OatApiwat/ROS_agv/README.md

# ROS_agv

## OverAll Project
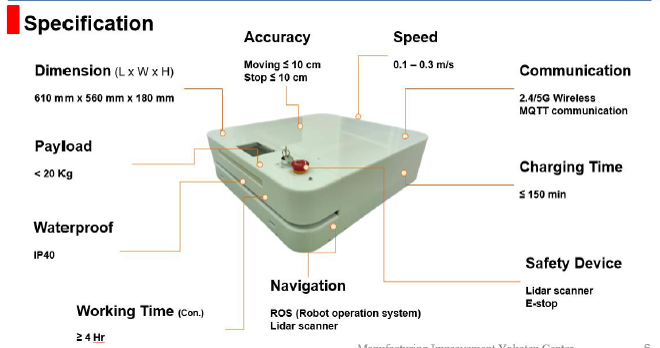
[picture p1: OverAll_AGV.png]
Specification AGV

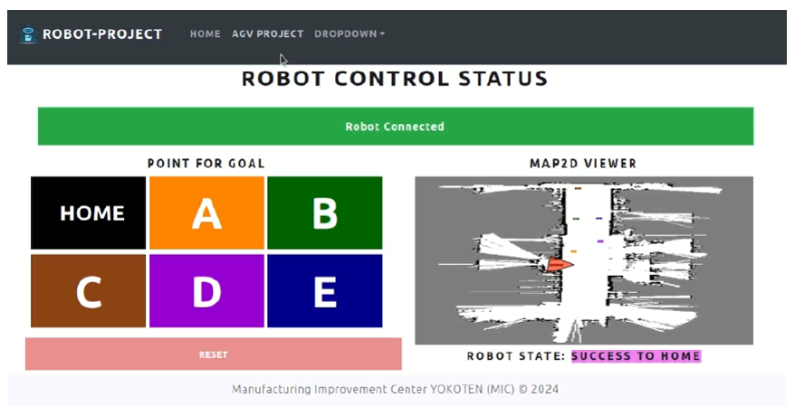
[picture p2: OverAll_web.png]
Web for control_AGV


## Link Working system
[AGV_working](https://youtu.be/HmGA6tf8itk )
[Point_to_Point](https://youtu.be/yPlYCydJhrE)
