OatApiwat/ROS_agv/dwg/Assy_encoder.FCStd

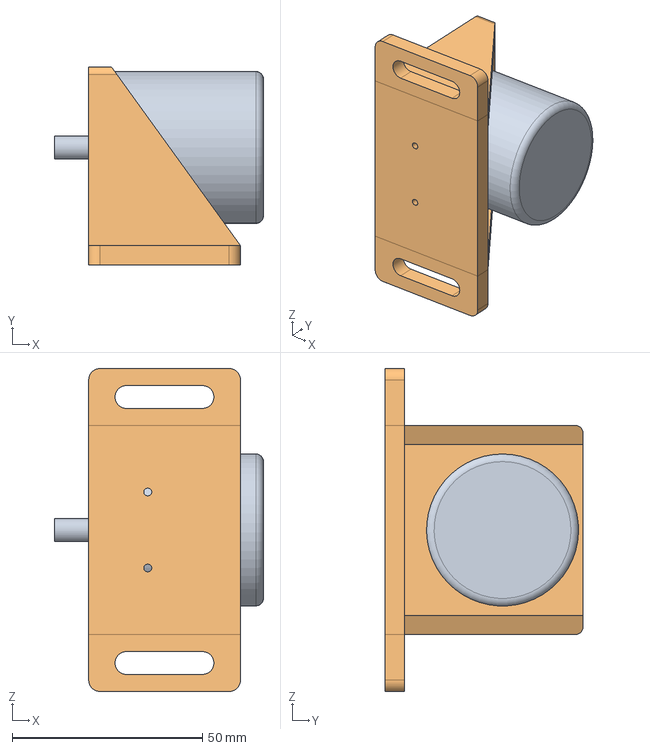
[picture p3: CAD file, 2025-02-19]
dwg/Assy_encoder.FCStd
55.0 x 52.1 x 85.0 mm
encoder_001
encoder_holder3_001
