OatApiwat/ROS_agv/dwg/assy.step

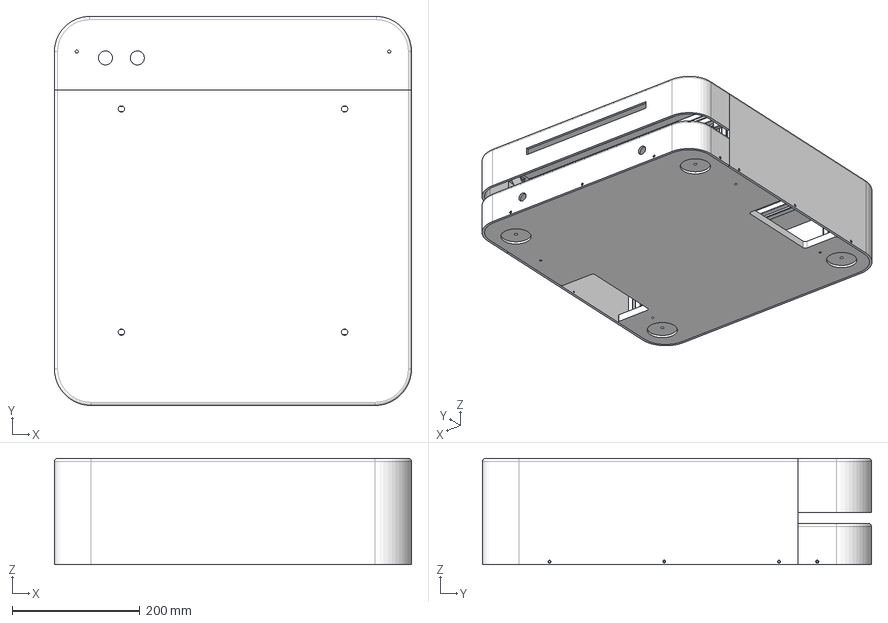
[picture p4: CAD file, 2025-02-19]
dwg/assy.step
560.0 x 610.0 x 167.0 mm
base_001
AGV02-102A_Front cover 1_001
AGV02-103A_Front cover 2_001
frame_set2_001
AGV02-104A_Top cover_001
