OatApiwat/ROS_agv/dwg/cover_wheel_12-6.FCStd

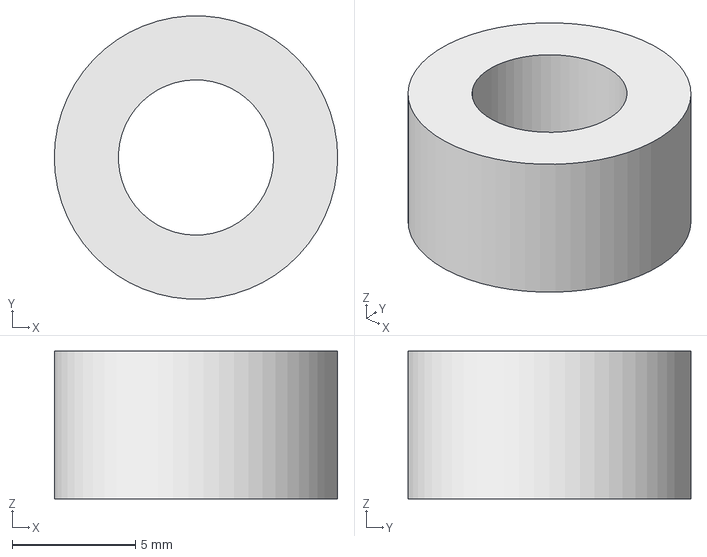
[picture p5: CAD file, 2025-02-19]
dwg/cover_wheel_12-6.FCStd
11.5 x 11.5 x 6.00 mm
