OatApiwat/ROS_agv/dwg/cover_wheel_12-8v2.FCStd

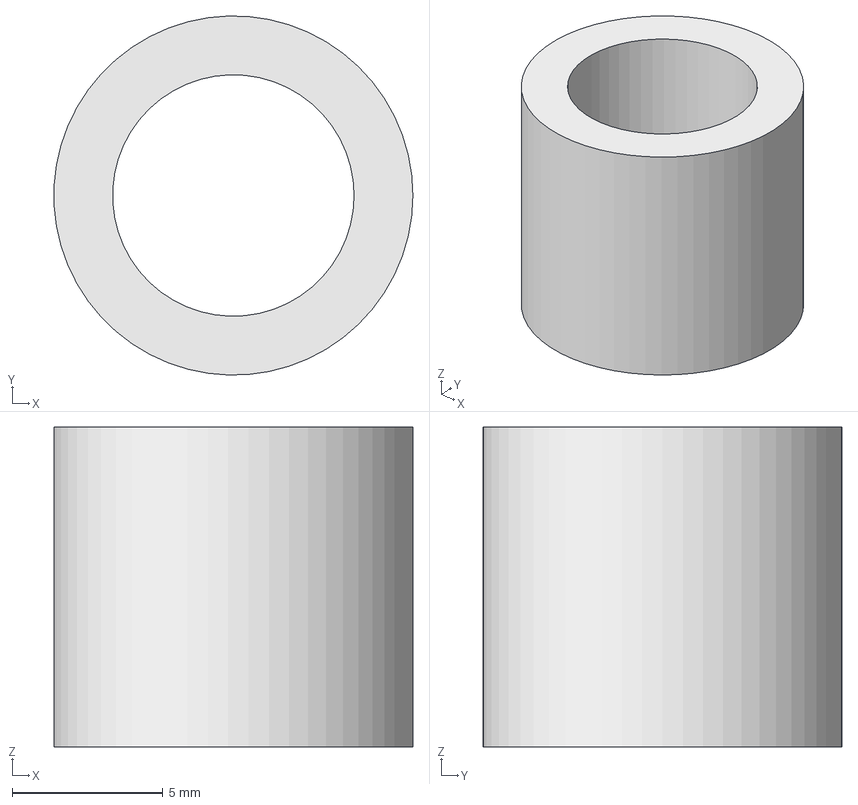
[picture p6: CAD file, 2025-02-19]
dwg/cover_wheel_12-8v2.FCStd
11.9 x 11.9 x 10.6 mm
