OatApiwat/ROS_agv/dwg/cover_wheel_8-6.FCStd

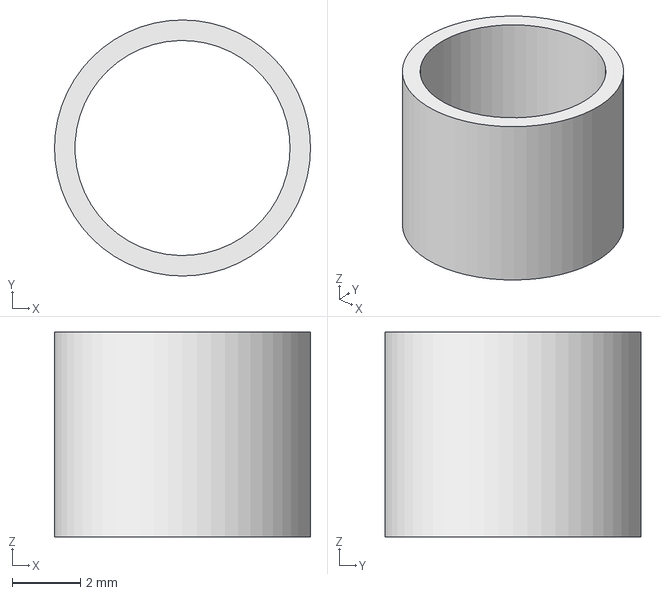
[picture p7: CAD file, 2025-02-19]
dwg/cover_wheel_8-6.FCStd
7.50 x 7.50 x 6.00 mm
