OatApiwat/ROS_agv/dwg/encoder_holder3-Body.stl

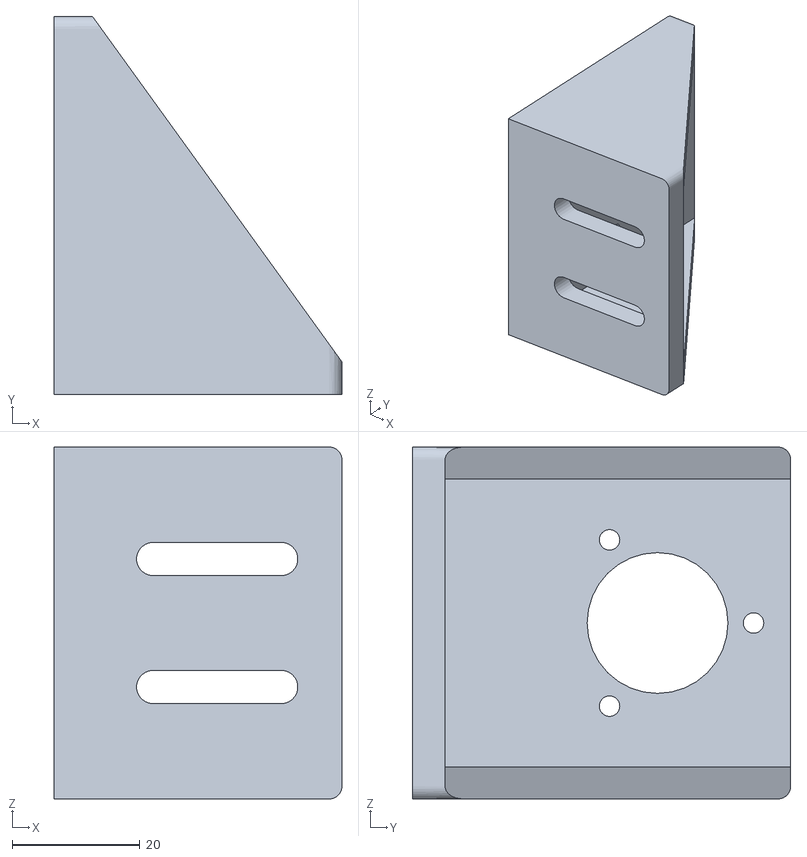
[picture p9: CAD file, 2025-02-19]
dwg/encoder_holder3-Body.stl
45.0 x 59.1 x 55.0
