OatApiwat/ROS_agv/dwg/Base_Lidar_Top-Body.stl

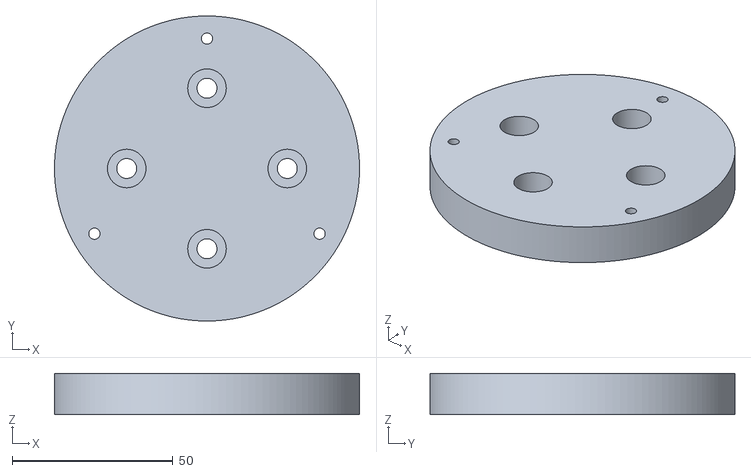
[picture p10: CAD file, 2025-02-19]
dwg/Base_Lidar_Top-Body.stl
95.0 x 95.0 x 12.8
