OatApiwat/ROS_agv/dwg/Base_Lidar.FCStd

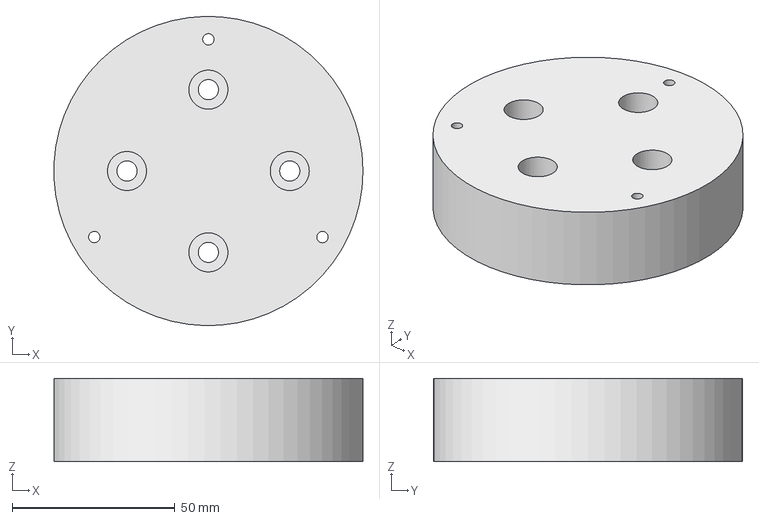
[picture p11: CAD file, 2025-02-19]
dwg/Base_Lidar.FCStd
94.9 x 95.0 x 25.6 mm
