OatApiwat/ROS_agv/dwg/AGV02-103A_Front cover 2.step

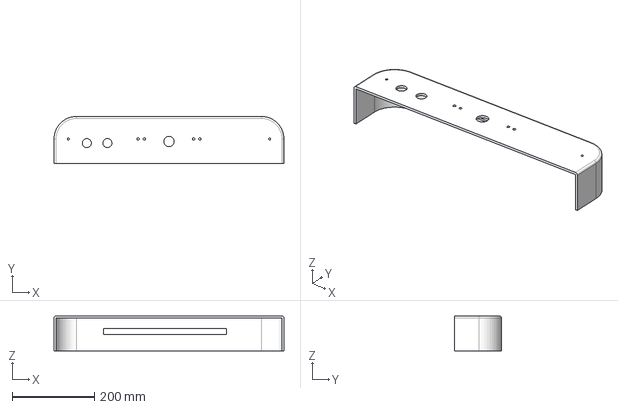
[picture p12: CAD file, 2025-02-19]
dwg/AGV02-103A_Front cover 2.step
560.0 x 115.0 x 85.0 mm
