OatApiwat/ROS_agv/dwg/AGV02-101A_Base chassis.step

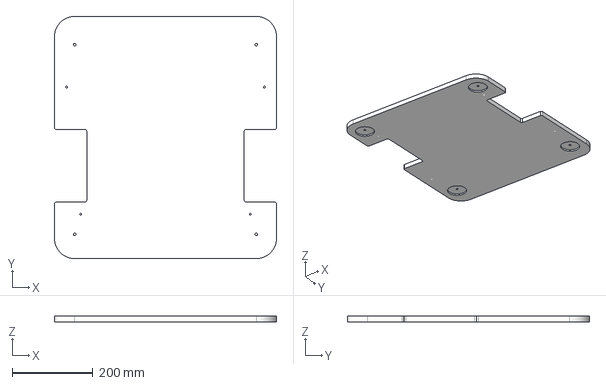
[picture p13: CAD file, 2025-02-19]
dwg/AGV02-101A_Base chassis.step
550.0 x 600.0 x 15.0 mm
