OatApiwat/ROS_agv/dwg/AGV02-104A_Top cover.step

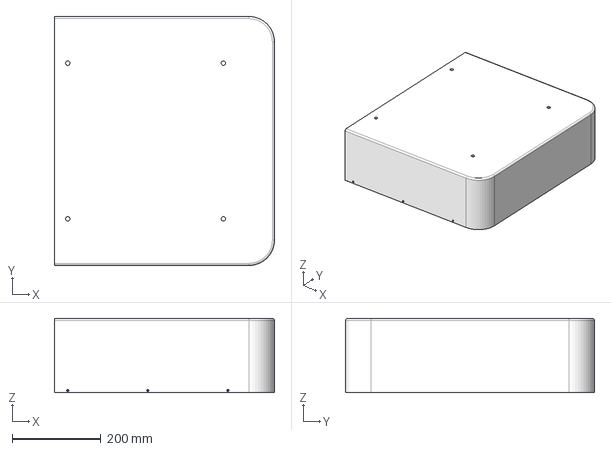
[picture p14: CAD file, 2025-02-19]
dwg/AGV02-104A_Top cover.step
495.0 x 560.0 x 167.0 mm
