OatApiwat/ROS_agv/dwg/motor24v.FCStd

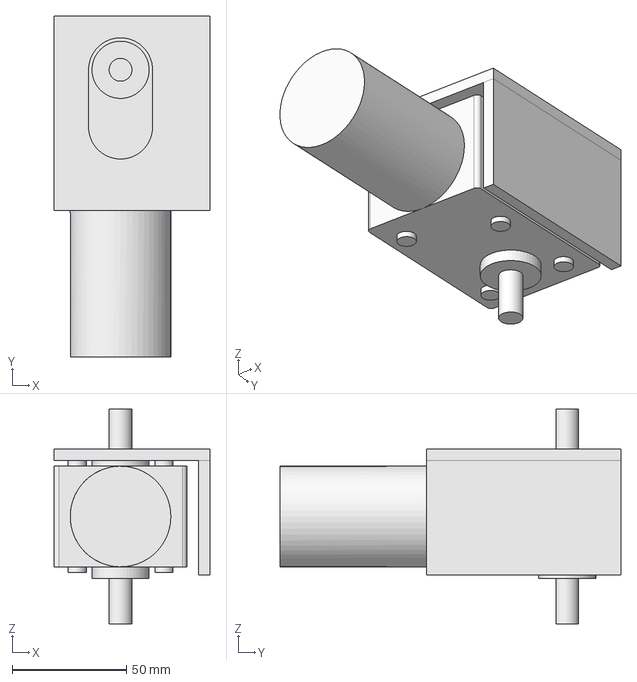
[picture p15: CAD file, 2025-02-19]
dwg/motor24v.FCStd
68.0 x 149.0 x 94.0 mm
