OatApiwat/ROS_agv/dwg/encoder_holder4-Body.stl

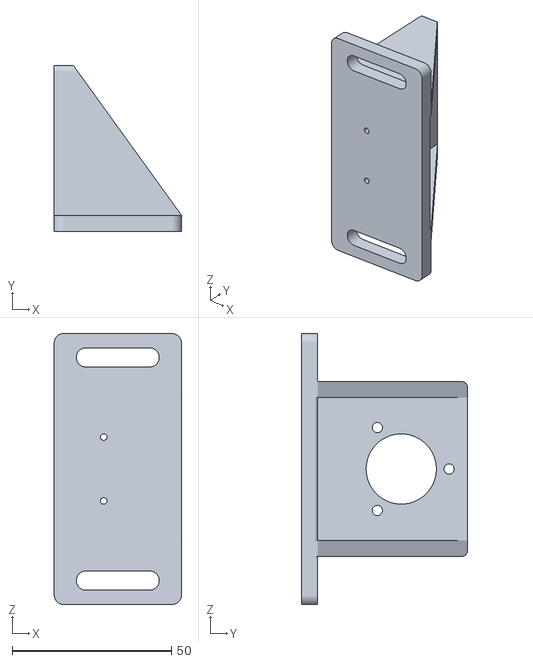
[picture p16: CAD file, 2025-02-19]
dwg/encoder_holder4-Body.stl
40.0 x 52.1 x 85.0
