OatApiwat/ROS_agv/dwg/encoder_holder.FCStd

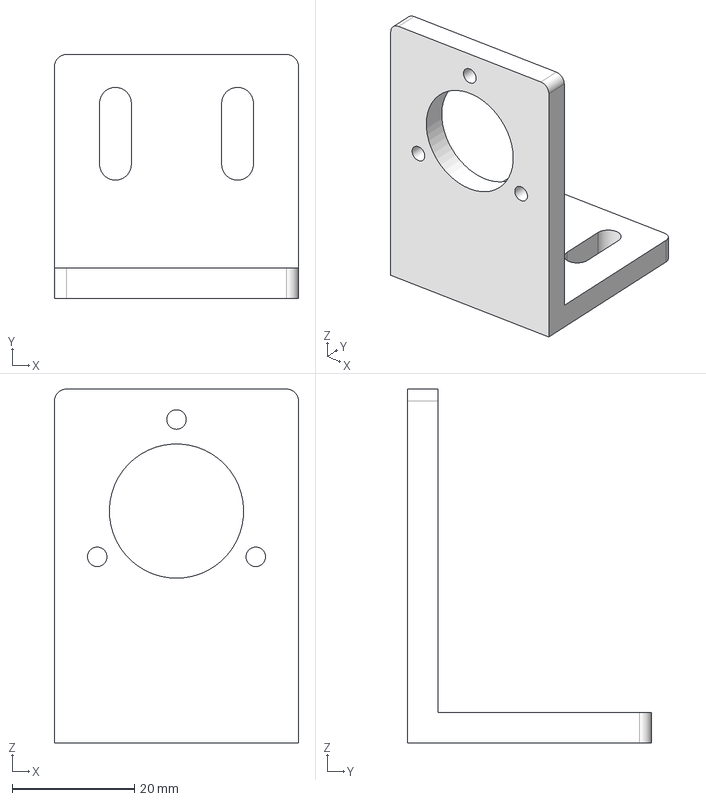
[picture p17: CAD file, 2025-02-19]
dwg/encoder_holder.FCStd
40.0 x 40.0 x 58.0 mm
