OatApiwat/ROS_agv/dwg/AGV02-102A_Front cover 1.step

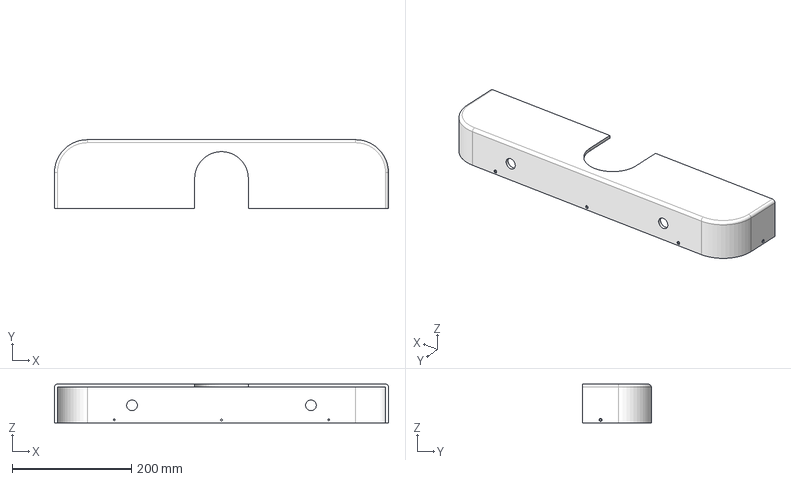
[picture p18: CAD file, 2025-02-19]
dwg/AGV02-102A_Front cover 1.step
560.0 x 115.0 x 65.0 mm
