OatApiwat/ROS_agv/dwg/encoder_holder2-Body.stl

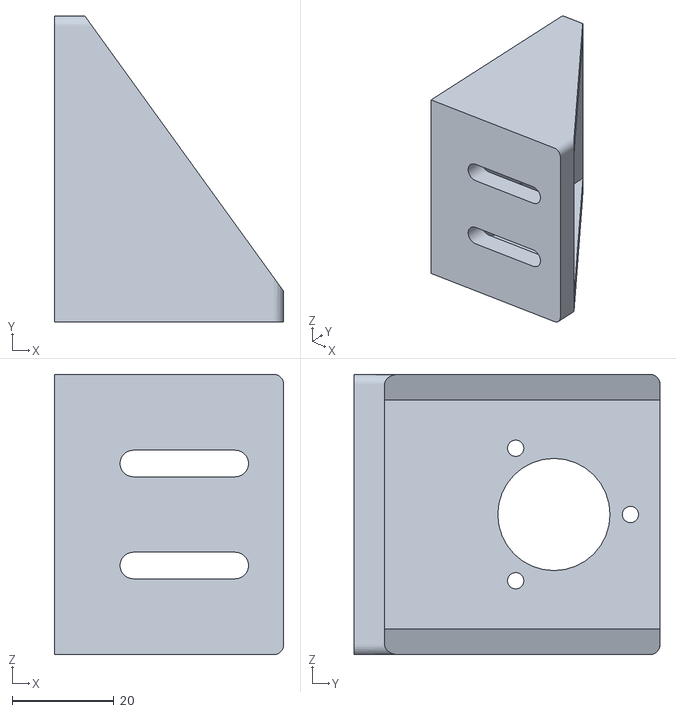
[picture p19: CAD file, 2025-02-19]
dwg/encoder_holder2-Body.stl
45.0 x 60.0 x 55.0
