OatApiwat/ROS_agv/dwg/encoder.FCStd

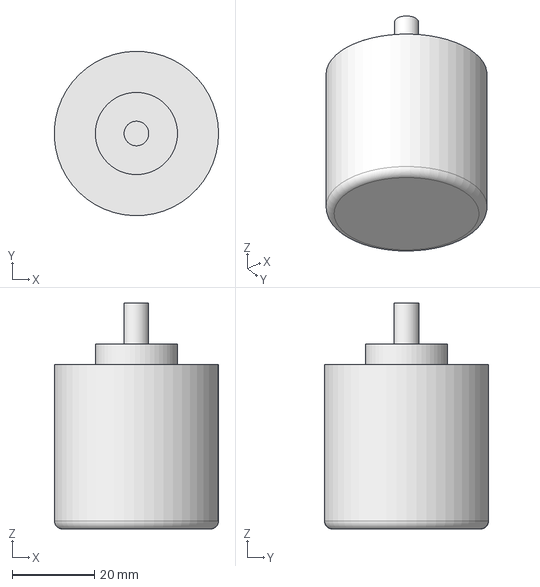
[picture p20: CAD file, 2025-02-19]
dwg/encoder.FCStd
40.0 x 40.0 x 55.0 mm
