OatApiwat/ROS_agv/dwg/Base_Lidar-Body.stl

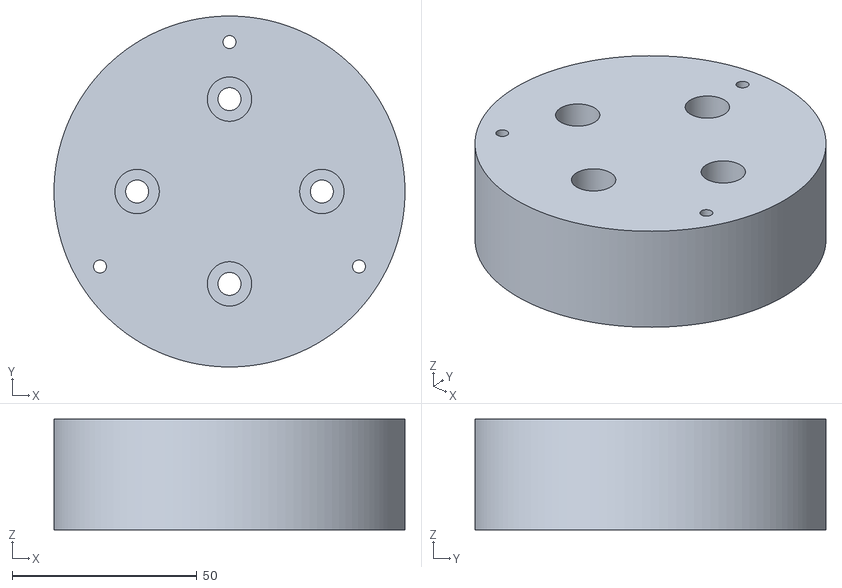
[picture p21: CAD file, 2025-02-19]
dwg/Base_Lidar-Body.stl
95.0 x 95.0 x 30.0
