OatApiwat/ROS_agv/dwg/cover_wheel_12-6-Body.stl

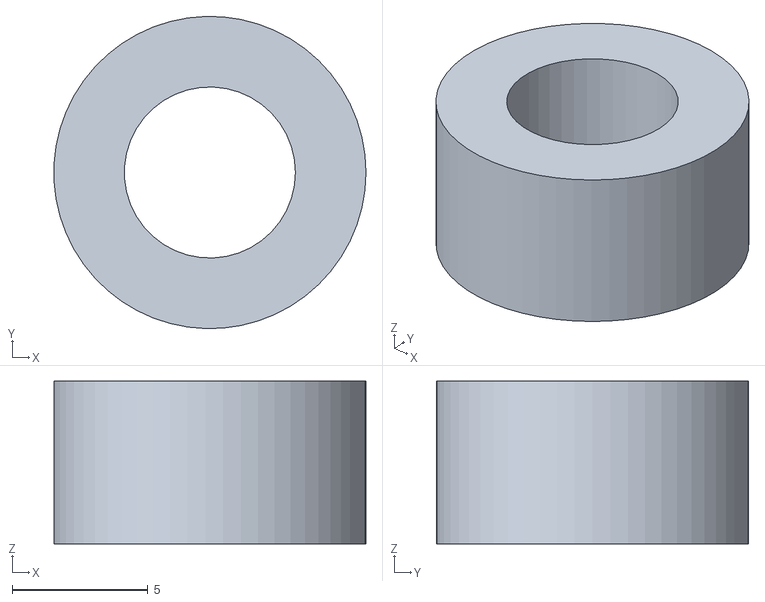
[picture p22: CAD file, 2025-02-19]
dwg/cover_wheel_12-6-Body.stl
11.5 x 11.5 x 6.00
