OatApiwat/ROS_agv/dwg/cover_wheel_12-8-Body.stl

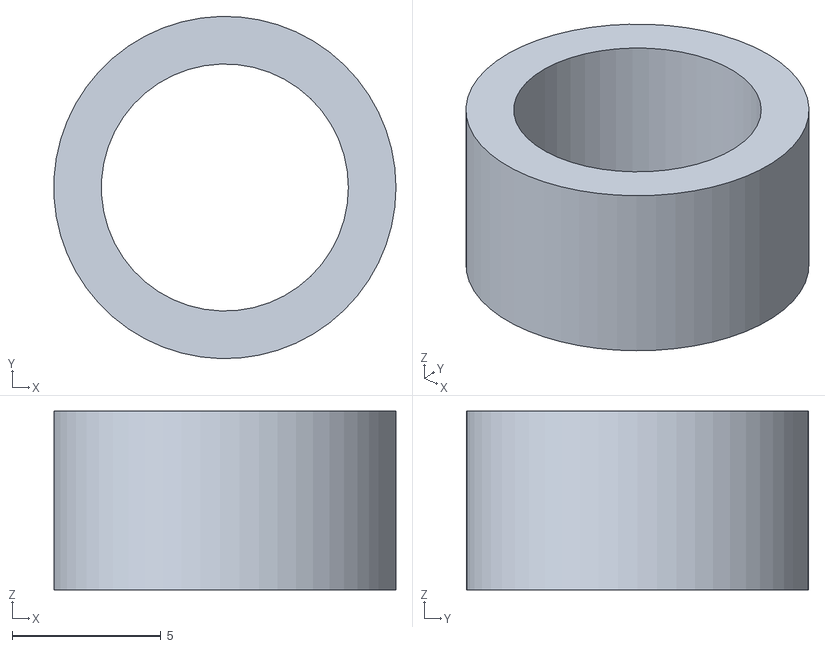
[picture p23: CAD file, 2025-02-19]
dwg/cover_wheel_12-8-Body.stl
11.5 x 11.5 x 6.00
