OatApiwat/ROS_agv/dwg/Base_Lidar_Bottom-Body.stl

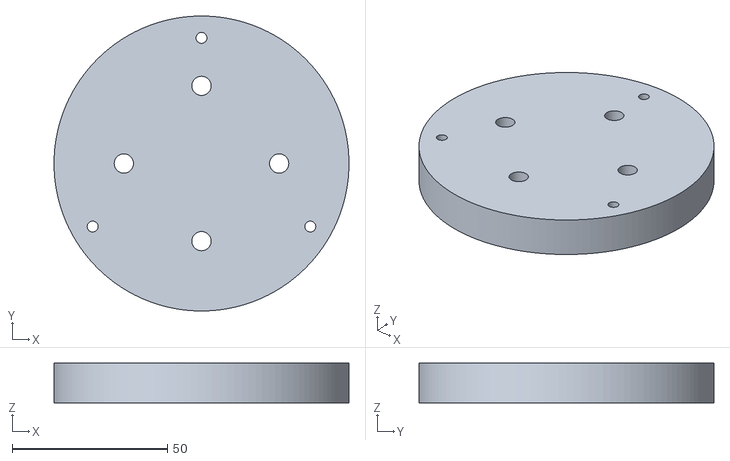
[picture p24: CAD file, 2025-02-19]
dwg/Base_Lidar_Bottom-Body.stl
95.0 x 95.0 x 12.8
