OatApiwat/ROS_agv/(list of files, cad)

Other CAD files:
dwg/cover_wheel_12-8v2-Body.stl
dwg/encoder_holder2.FCStd
dwg/encoder_holder3.FCStd
dwg/cover_wheel_8-6-Body.stl
dwg/AGV02-101A_Base chassis.FCStd
dwg/AGV02-102A_Front cover 1.FCStd
dwg/AGV02-103A_Front cover 2.FCStd
dwg/AGV02-104A_Top cover.FCStd
dwg/assy.FCStd
