OatApiwat/ROS_agv/Test_report_new_ware_house_lobburi_8-9_07_2024.docx

Objective: To test opportunity for AGV surveying in New ware-house LopBuri

Date: 8-9 July 2024

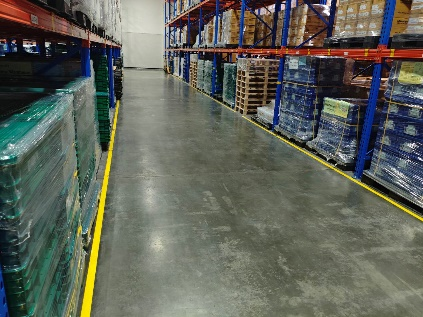
[picture p26: figure]

Location: New ware-house block 36

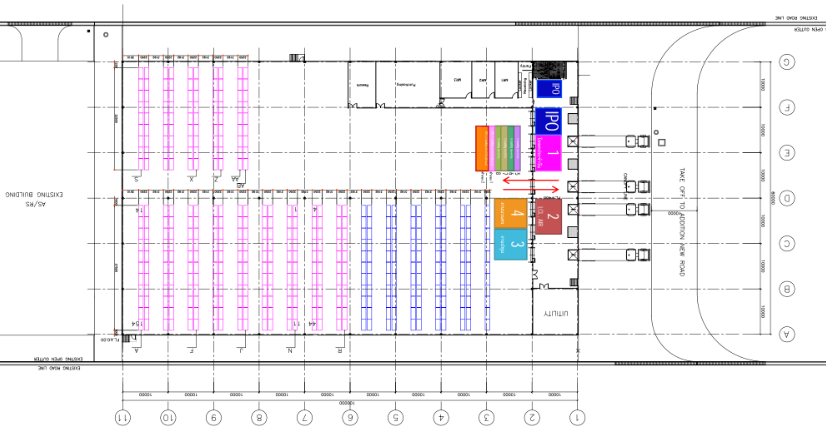
[picture p27: figure]

Equipment: AGV MICKY50

Specification:

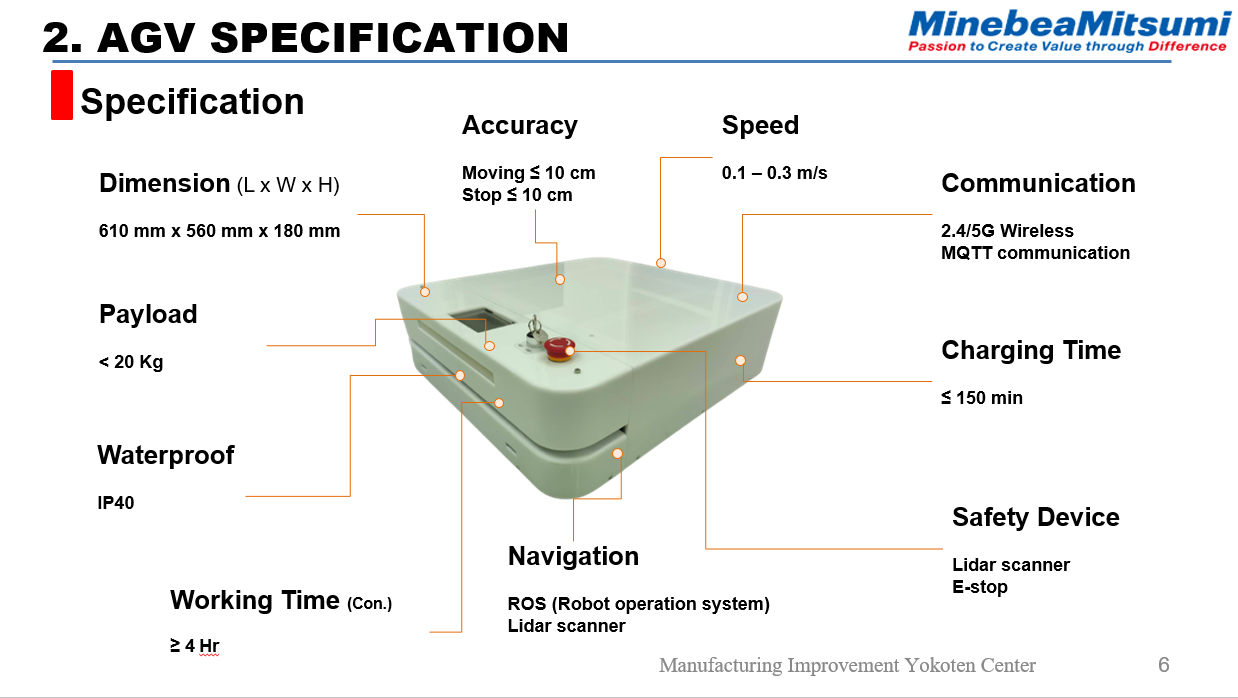
[picture p28: figure]

Topic:

1. Creating Map and difference map pattern for testing.
2. Testing condition and result.
3. Problem.
4. Conclusion.
1. Creating Map and difference map pattern for testing.

For this test, we tested at New-Warehouse. Which is always rack being moved therefore the test has different maps for different test times as follows:

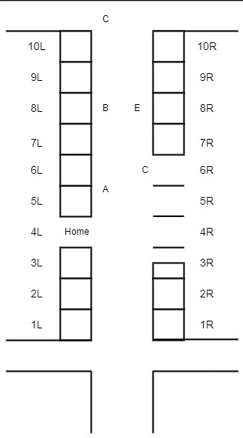
[picture p29: figure]
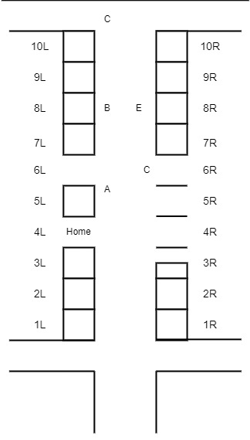
[picture p30: figure]
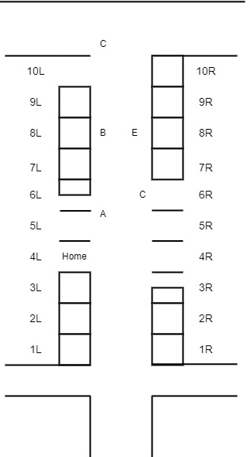
[picture p31: figure]

(A) Morning 08-07-2024 (B) Evening 08-07-2024 (C) 09-07-2024

Picture 1 Map layout for New-Ware House Block 36

From the picture 1. Rack was moved from old state that rack 6L moved on evening 08-07-2024 and rack 5L moved on 09-07-2024 that effect to AGV moving and we explain in topic 3 problem. However, for this test we use map that created on Morning 08-07-2024 for data collection as below:

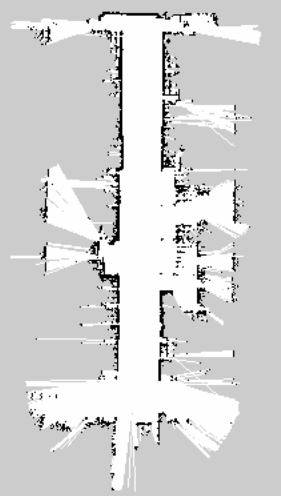
[picture p32: figure]

Picture 2. Map for AGV create on Morning 08-07-2024

2. Testing condition and result.
  2.1 Testing moving AGV to Position by using Web Application.

We use React for design Web Application using ROSLIB to communicate between React and ROS.

Testing condition:

- Control AGV by touch button on the screen for every button.
- Record moving data.

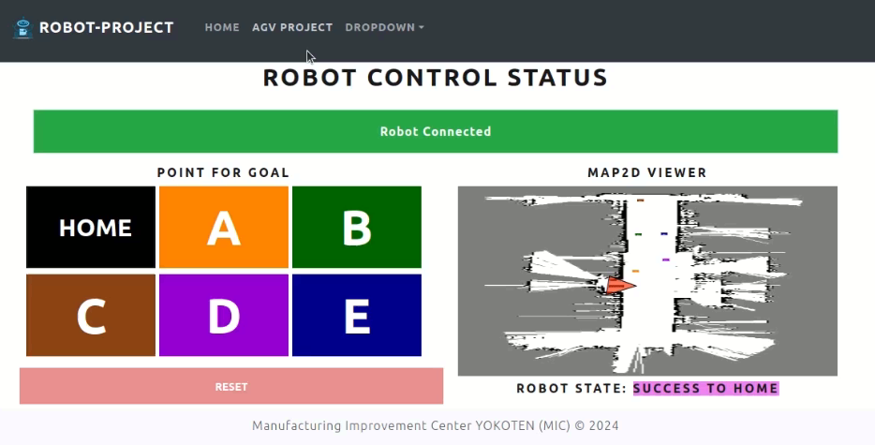
[picture p33: figure]

Picture 3. Web Application page for control AGV

Testing Result:

Start/Goal | Home | A | B | C | D | E
Home | ✅ | ✅ | ✅ | ✅ | ✅ | ✅
A | ✅ | ✅ | ✅ | ✅ | ✅ | ✅
B | ✅ | ✅ | ✅ | ✅ | ✅ | ✅
C | ✅ | ✅ | ✅ | ✅ | ✅ | ✅
D | ✅ | ✅ | ✅ | ✅ | ✅ | ✅
E | ✅ | ✅ | ✅ | ✅ | ✅ | ✅

Table 1. Testing result for moving from start point to goal point

From picture 3 and table 1. User can control AGV by touching button that need to be goal of AGV on the screen. For the result, we found that AGV is able to move to every point as the command from user (Video Link: https://youtu.be/6zdblH6UEzM)

2.2 Avoidance person standing in the front of AGV (AGV move to front direction of person).

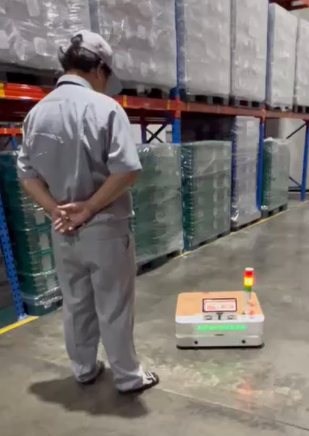
[picture p34: figure]
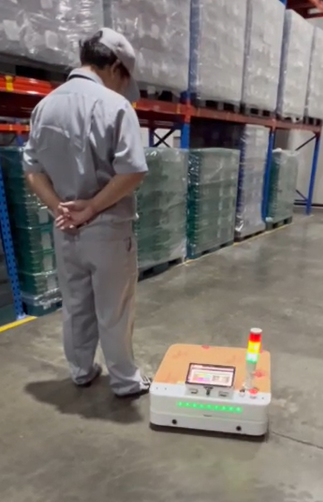
[picture p35: figure]
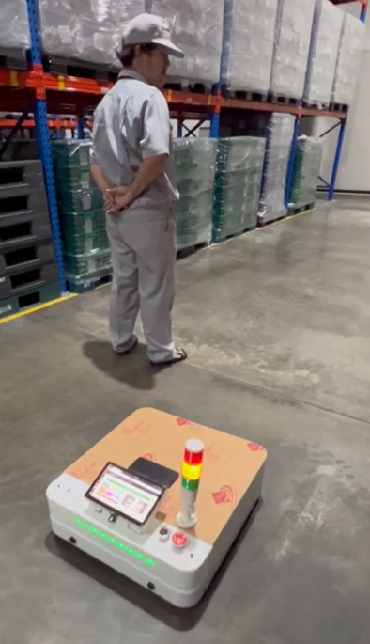
[picture p36: figure]

Picture 4. Avoidance Person standing in the front of AGV

(Video Link: https://youtu.be/ZW2OfCaQo_c)

From the picture 3. AGV can avoid stationary person by moving around them from the rear direction effectively with distance about 10-30 cm that is acceptable distance for working.

  2.3 Avoidance person moving to the front of AGV (AGV move to front direction of person).

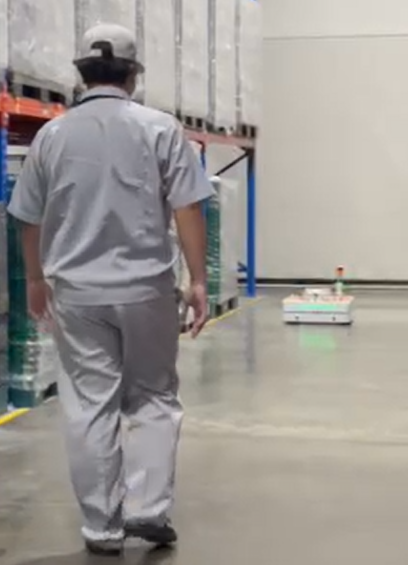
[picture p37: figure]
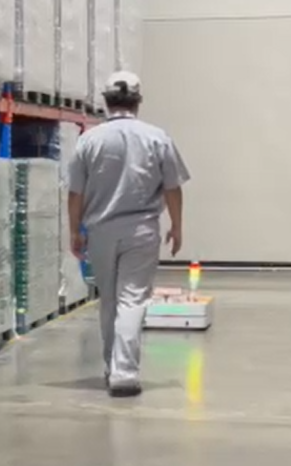
[picture p38: figure]
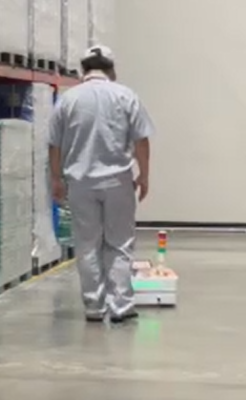
[picture p39: figure]
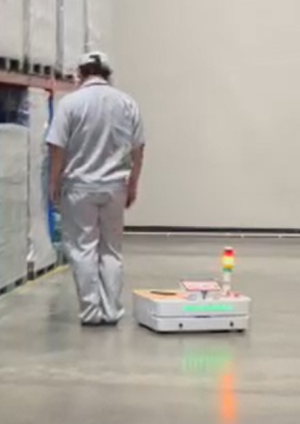
[picture p40: figure]
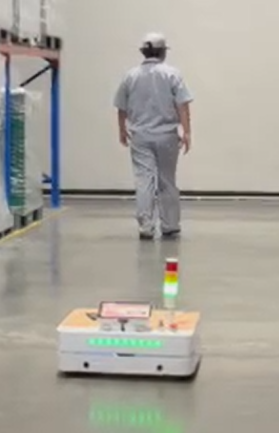
[picture p41: figure]

Picture 5. Avoidance Person moving to the front of AGV

(Video Link: https://youtu.be/vzY4oO30h_Q )

From the picture 5. AGV can avoid stationary person by moving around them from the rear direction effectively with distance about 10-30 cm that is acceptable distance for working. But worker has to stop in the front of AGV for AGV avoid pass worker.

  2.4 Record data on database

For testing record data into data base, we tested by sent command to AGV move in the loop (Home -> A -> B -> C -> D -> E -> Home) as picture 6.

Picture 6. Moving path for AGV

The result shown in table below:

No | Point | Duration (sec) | Distance (m) | Speed (m/s) | Battery Usage (Volt)
1 | H -> A -> B -> C -> D -> E -> H | 195 | 47.4748 | 0.243461 | 0.0088252
2 | H -> A -> B -> C -> D -> E -> H | 198 | 48.25178 | 0.243696 | 0.0088252
3 | H -> A -> B -> C -> D -> E -> H | 160 | 47.25153 | 0.295322 | 0.0087252
4 | H -> A -> B -> C -> D -> E -> H | 158 | 47.22039 | 0.298863 | 0.008722
5 | H -> A -> B -> C -> D -> E -> H | 163 | 47.33342 | 0.290389 | 0.0087333
6 | H -> A -> B -> C -> D -> E -> H | 152 | 44.18583 | 0.290696 | 0.0084186
7 | H -> A -> B -> C -> D -> E -> H | 157 | 47.07347 | 0.299831 | 0.0087073
8 | H -> A -> B -> C -> D -> E -> H | 157 | 47.16607 | 0.300421 | 0.0087166
9 | H -> A -> B -> C -> D -> E -> H | 165 | 48.33975 | 0.292968 | 0.008834
10 | H -> A -> B -> C -> D -> E -> H | 155 | 47.12492 | 0.304032 | 0.0087125
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
43 | H -> A -> B -> C -> D -> E -> H | 170 | 49.01134 | 0.288302 | 0.0089011
44 | H -> A -> B -> C -> D -> E -> H | 166 | 48.20652 | 0.290401 | 0.0088207
Average | | 165.3953 | 47.48419 | 0.28947 | 0.008750184

Table 2 Data for data collection

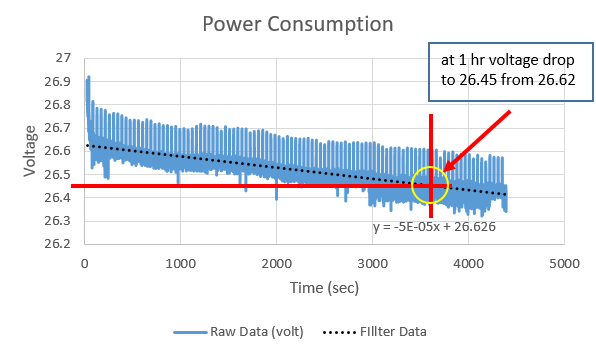
[picture p42: figure]

Picture 7 voltage remain VS Time

From Table 2 and picture 7., it is shown that within one moving loop, the AGV has an average distance of 47.48 meters, using 164.54 seconds per round and power consuming 0.00875 volts (approximately 15 Ah) with an average speed of 0.289 m/s, which is less than the worker's speed (approximately 0.5-1 m/s). For continuous operation with one battery change, the total distance the AGV can cover is about 4,134.30 meters or about 4 hours. Additionally, for continuous operation over one day (8 hours), the AGV can move a distance of about 8268.6 meters and requires two battery changes per day (150 minutes total changing time).

From table 2, data recorded and added into database.

3. Problem

While testing we found problem for difference map below:

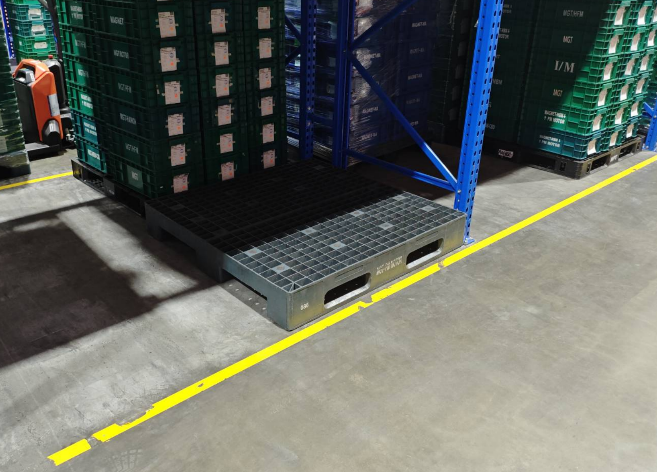
[picture p43: figure]
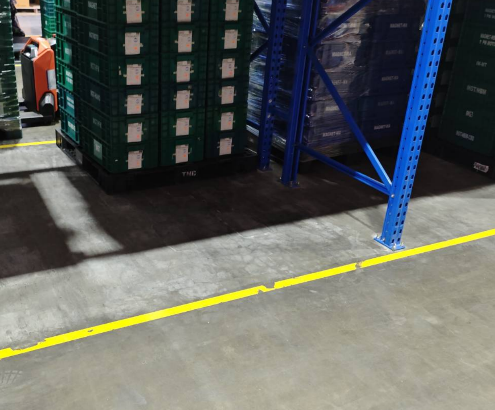
[picture p44: figure]

Picture 10 rack at area 5L

As picture 1 (B) and (C), the rack 5L was removed from that area, testing result shown that 2/5 (40%) times. AGV will move to point A1 instead of A (Picture 11) because the reference area on the left is missing causing the Lidar to malfunction that mistake and make AGV collision with obstacles.

A1

Picture 11 mistake Area

4. Conclusion

The AGV MICKY50 demonstrated reliable performance under controlled conditions using the created map from the morning of 08-07-2024. It successfully navigated between predefined points (Home, A, B, C, D, E) using a web application interface integrated with ROSLIB for communication with ROS. The tests confirmed:

Mapping and Navigation: The AGV effectively utilized the morning map of 08-07-2024 to navigate through the warehouse, demonstrating flexibility in adapting to different layouts.

Obstacle Avoidance: It demonstrated effective obstacle avoidance when encountering stationary and moving persons, maintaining a safe distance of 10-30 cm, which is suitable for operational safety.

Data Collection and Analysis: Recorded data on movement points, duration, and distance for both testing days were logged into the database, providing valuable insights into operational metrics.

Within one moving loop, the AGV has an average distance of 47.48 meters, using 164.54 seconds per round and consuming 0.00475 volts (approximately 15 Ah) with an average speed of 0.289 m/s, which is less than the worker's speed (approximately 0.5-1 m/s). For continuous operation with one battery change, the total distance the AGV can cover is about 4,134.30 meters or about 4 hours. Additionally, for continuous operation over one day (8 hours), the AGV can move a distance of about 8268.6 meters and requires two battery changes per day (150 minutes total changing time)

The primary challenge observed was the sensitivity of AGV navigation to changes in the environment, specifically when racks were moved (as observed with Rack 5L). This led to navigation errors due to outdated map references, resulting in potential collisions or navigation to incorrect points

Manufacturing Improvement Center YOKOTEN (MIC) 6

AGV Testing Report New Ware-House LopBuriApiwat Nonut 20-Jun-2024
