OatApiwat/ROS_agv/AGV1/src/agv_pkg/config/gmapping_params.yaml

map_update_interval: 1.0 #1.0
maxUrange: 8.0
sigma: 0.05
kernelSize: 1
lstep: 0.05
astep: 0.05
iterations: 5
lsigma: 0.075
ogain: 3.0
lskip: 0
minimumScore: 50
srr: 0.1
srt: 0.2
str: 0.1
stt: 0.2
linearUpdate: 1.0
angularUpdate: 0.2
temporalUpdate: 0.5
resampleThreshold: 0.5
particles: 100
xmin: -10.0 #-50
ymin: -10.0 #-50
xmax: 10.0 #50
ymax: 10.0 #50
delta: 0.10
llsamplerange: 0.01
llsamplestep: 0.01
lasamplerange: 0.005
lasamplestep: 0.005
